nmolberg/hardware_dev/Pressure Broom 2/Pressure Broom 2.kicad_pcb

## KiCad design Pressure Broom 2/Pressure Broom 2.kicad_pcb (2025-07-15)

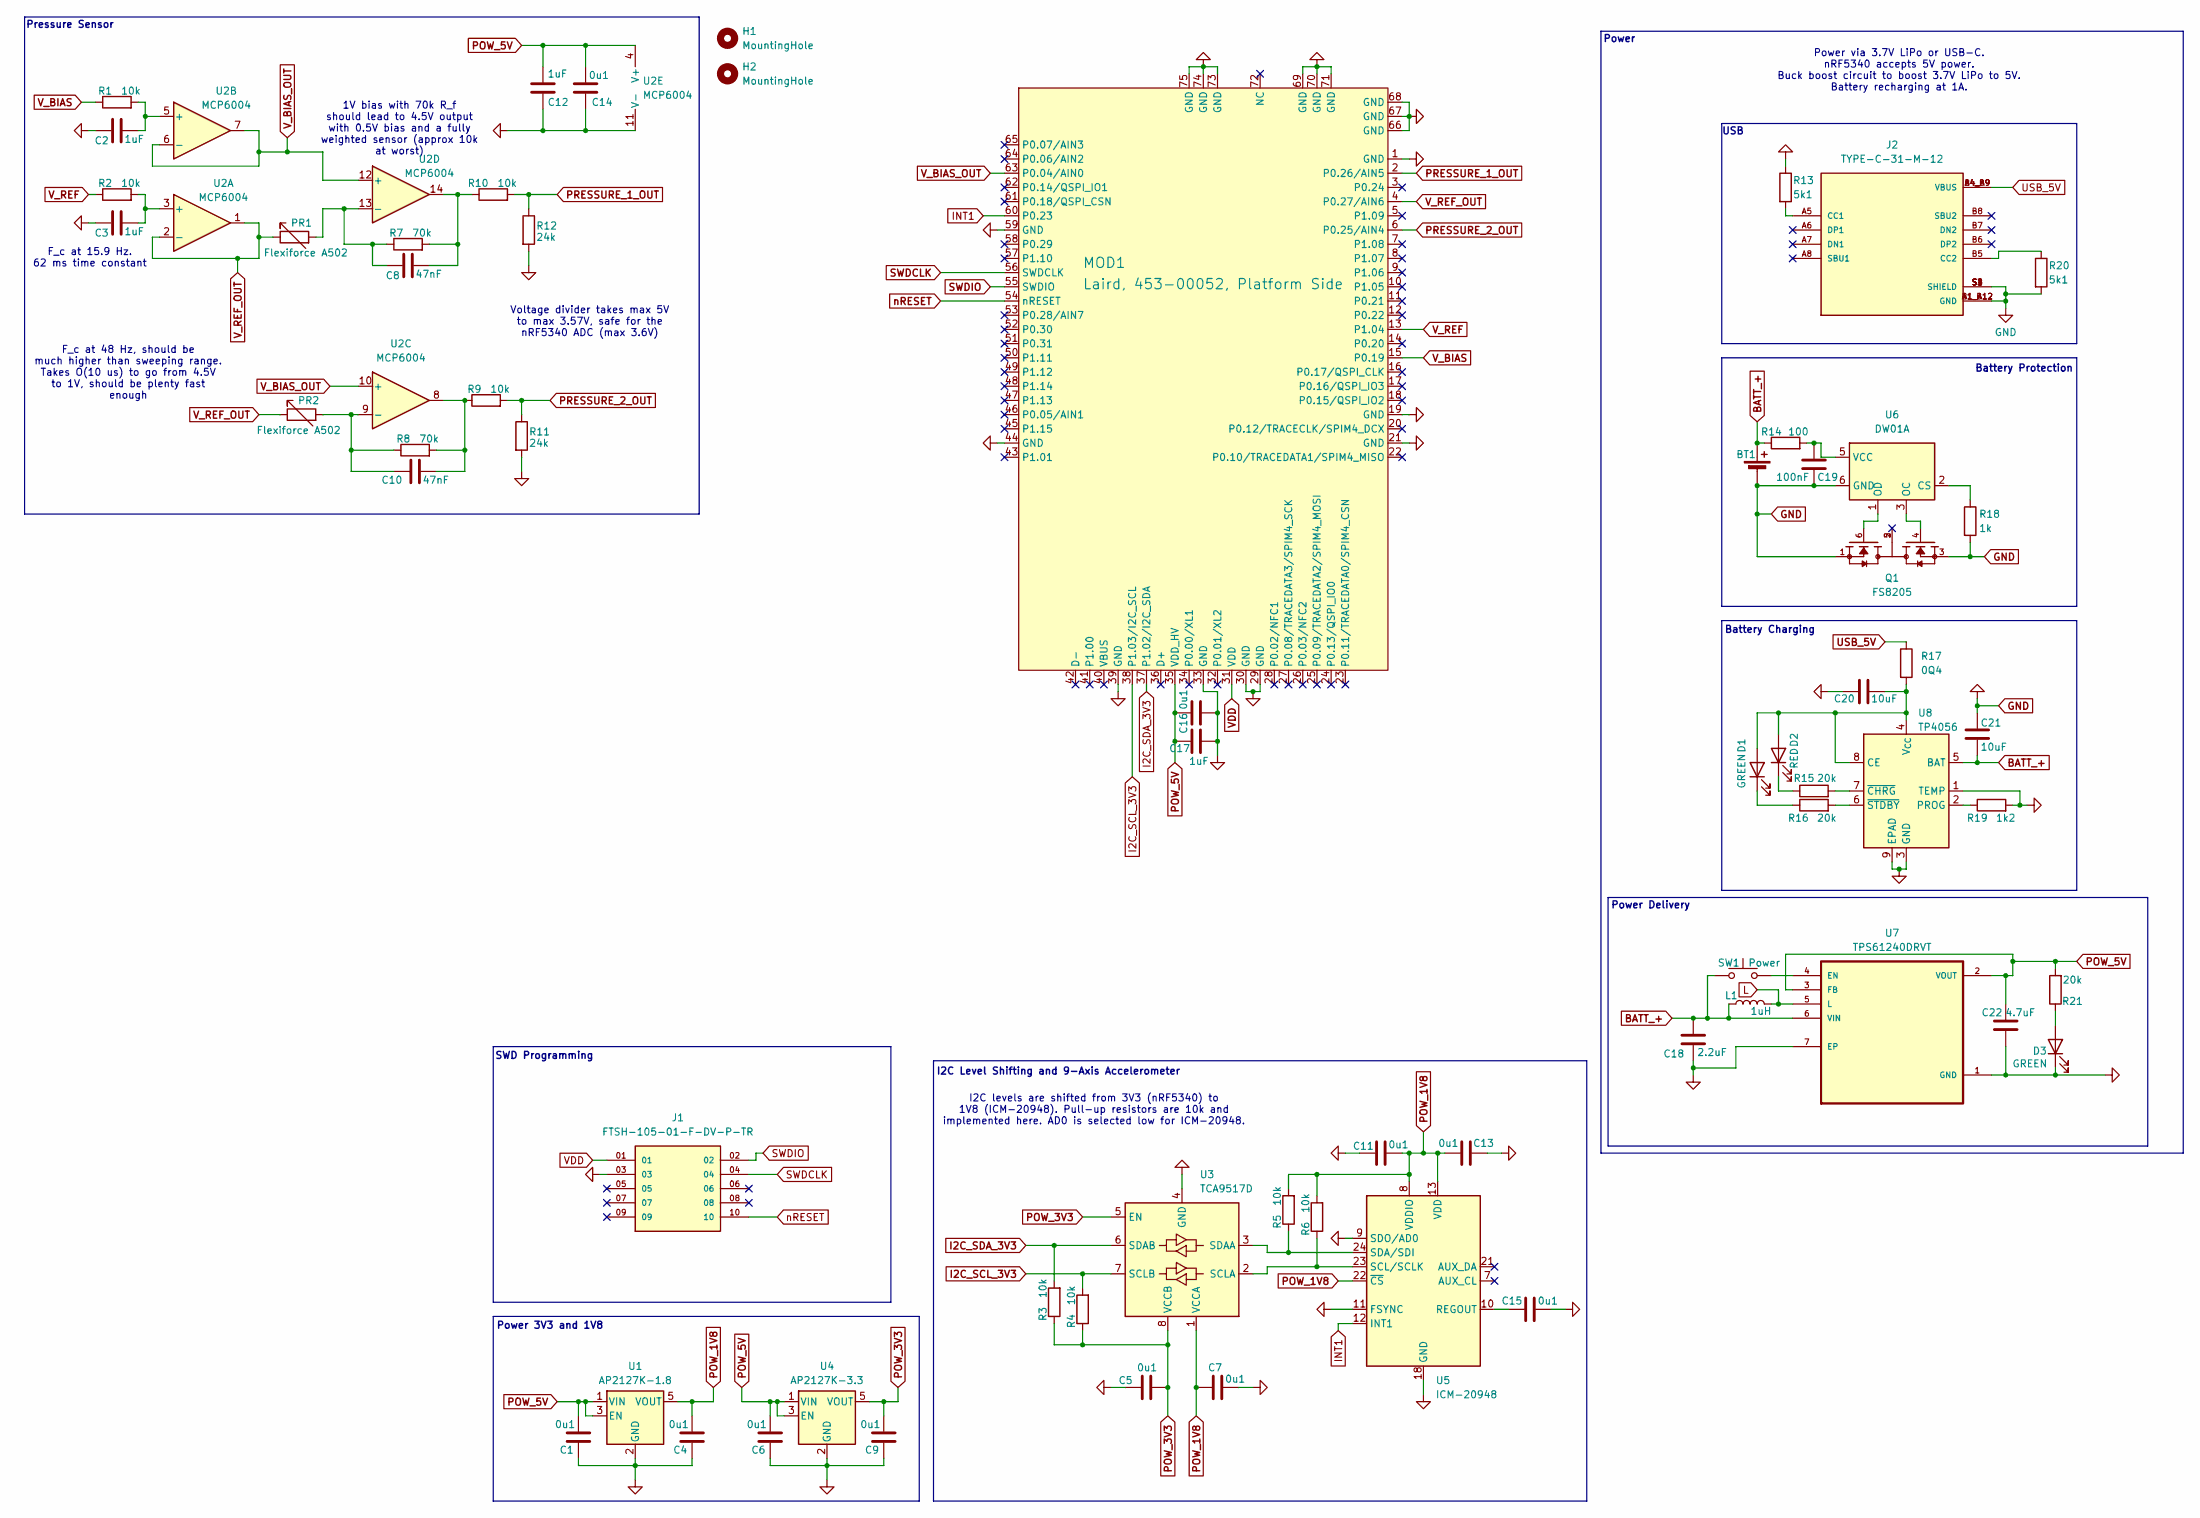
[picture p1: schematic Pressure Broom 2.kicad_sch]

Parts:
BT1: Battery_Cell; JST_PH_S2B-PH-K_1x02_P2.00mm_Horizontal
C1, C4, C5, C6, C7, C9, C11, C13, C14, C15: 0u1; C_0402_1005Metric
C2, C3, C12: 1uF; C_0402_1005Metric
C8, C10: 47nF; C_0402_1005Metric
C16: 0u1; C_0603_1608Metric
C17: 1uF; C_0603_1608Metric
C18: 2.2uF; C_0603_1608Metric
C19: 100nF; C_0603_1608Metric
C20, C21: 10uF; C_0603_1608Metric
C22: 4.7uF; C_0603_1608Metric
D1, D3: GREEN; LED_0402_1005Metric
D2: RED; LED_0402_1005Metric
H1, H2: MountingHole; MountingHole_2.2mm_M2
J1: FTSH-105-01-F-DV-P-TR; SAMTEC_FTSH-105-01-F-DV-P-TR; PARTREV R
J2: TYPE-C-31-M-12; HRO_TYPE-C-31-M-12; PARTREV 2020.12.08
L1: 1uH; L_0603_1608Metric; Part LQM21PN1R0MC0
MOD1: Laird, 453-00052, Platform Side; Ezurio Module; Manufacturer Part Number 453-00052
PR1, PR2: Flexiforce A502; Tekscan Pressure Sensor
Q1: FS8205; SOT95P280X145-6N; PARTREV 1.9
R1, R2, R3, R5, R9, R10: 10k; R_0402_1005Metric_Pad0.72x0.64mm_HandSolder
R4, R6: 10k; R_0603_1608Metric
R7, R8: 70k; R_0402_1005Metric_Pad0.72x0.64mm_HandSolder
R11, R12: 24k; R_0402_1005Metric_Pad0.72x0.64mm_HandSolder
R13, R20: 5k1; R_0402_1005Metric_Pad0.72x0.64mm_HandSolder
R14: 100; R_0402_1005Metric_Pad0.72x0.64mm_HandSolder
R15, R16, R21: 20k; R_0402_1005Metric_Pad0.72x0.64mm_HandSolder
R17: 0Q4; R_0402_1005Metric_Pad0.72x0.64mm_HandSolder
R18: 1k; R_0402_1005Metric_Pad0.72x0.64mm_HandSolder
R19: 1k2; R_0402_1005Metric_Pad0.72x0.64mm_HandSolder
SW1: Power; YTSPS-22E58LM
U1: AP2127K-1.8; SOT-23-5
U2: MCP6004; SOP65P640X120-14N
U3: TCA9517D; VSSOP-8_3x3mm_P0.65mm
U4: AP2127K-3.3; SOT-23-5
U5: ICM-20948; InvenSense_QFN-24_3x3mm_P0.4mm
U6: DW01A; SOT-23-6
U7: TPS61240DRVT
U8: TP4056; SOIC-8-1EP_3.9x4.9mm_P1.27mm_EP2.41x3.3mm_ThermalVias

Connections:
BATT_+: BT1.1 (+), C18.2, C21.2, L1.1, R14.1, SW1.1, U7.6 (VIN), U8.5 (BAT)
GND: BT1.2 (-), C1.1, C2.2, C3.2, C4.1, C5.2, C6.1, C7.1, C9.1, C11.2, C12.2, C13.2, C14.2, C15.2, C16.2, C17.2, C18.1, C19.2, C20.1, C21.1, C22.1, D3.1 (K), J1.03, J2.A1_B12 (GND), J2.B1_A12 (GND), J2.S1 (SHIELD), J2.S2 (SHIELD), J2.S3 (SHIELD), J2.S4 (SHIELD), MOD1.1 (GND), MOD1.19 (GND), MOD1.21 (GND), MOD1.29 (GND), MOD1.30 (GND), MOD1.33 (GND), MOD1.39 (GND), MOD1.44 (GND), MOD1.59 (GND), MOD1.66 (GND), MOD1.67 (GND), MOD1.68 (GND), MOD1.69 (GND), MOD1.70 (GND), MOD1.71 (GND), MOD1.73 (GND), MOD1.74 (GND), MOD1.75 (GND), Q1.1, Q1.3, R11.2, R12.2, R13.1, R18.2, R19.2, R20.2, U1.2 (GND), U2.11 (V-), U3.4 (GND), U4.2 (GND), U5.9 (SDO/AD0), U5.11 (FSYNC), U5.18 (GND), U5.20 (GND), U6.6 (GND), U7.1 (GND), U7.7 (EP), U8.1 (TEMP), U8.3 (GND), U8.9 (EPAD)
I2C_SCL_3V3: MOD1.38 (P1.03/I2C_SCL), R4.2, U3.7 (SCLB)
I2C_SDA_3V3: MOD1.37 (P1.02/I2C_SDA), R3.2, U3.6 (SDAB)
INT1: MOD1.60 (P0.23), U5.12 (INT1)
L: L1.2, U7.5 (L)
unnamed: C8.1, R7.2, R10.1, U2.14
unnamed: C10.1, R8.2, R9.1, U2.8
unnamed: C20.2, D1.2 (A), D2.2 (A), R17.2, U8.4 (V_{CC}), U8.8 (CE)
unnamed: D1.1 (K), R16.1
unnamed: D2.1 (K), R15.1
unnamed: D3.2 (A), R21.1
unnamed: J2.A5 (CC1), R13.2
unnamed: J2.B5 (CC2), R20.1
unnamed: C3.1, R2.2, U2.3 (+)
unnamed: C2.1, R1.2, U2.5 (+)
unnamed: C10.2, PR2.2, R8.1, U2.9 (-)
unnamed: C8.2, PR1.2, R7.1, U2.13 (-)
unnamed: R6.1, U3.2 (SCLA), U5.23 (SCL/SCLK)
unnamed: R5.1, U3.3 (SDAA), U5.24 (SDA/SDI)
unnamed: C15.1, U5.10 (REGOUT)
unnamed: R18.1, U6.2 (CS)
unnamed: Q1.4, U6.3 (OC)
unnamed: Q1.6, U6.1 (OD)
unnamed: C19.1, R14.2, U6.5 (VCC)
unnamed: SW1.2, U7.4 (EN)
unnamed: R19.1, U8.2 (PROG)
unnamed: R15.2, U8.7 (~CHRG)
unnamed: R16.2, U8.6 (~STDBY)
POW_1V8: C4.2, C7.2, C11.1, C13.1, R5.2, R6.2, U1.5 (VOUT), U3.1 (VCCA), U5.8 (VDDIO), U5.13 (VDD), U5.22 (~CS)
POW_3V3: C5.1, C9.2, R3.1, R4.1, U3.5 (EN), U3.8 (VCCB), U4.5 (VOUT)
POW_5V: C1.2, C6.2, C12.1, C14.1, C16.1, C17.1, C22.2, MOD1.35 (VDD_HV), R21.2, U1.1 (VIN), U1.3 (EN), U2.4 (V+), U4.1 (VIN), U4.3 (EN), U7.2 (VOUT), U7.3 (FB)
PRESSURE_1_OUT: MOD1.2 (P0.26/AIN5), R10.2, R12.1
PRESSURE_2_OUT: MOD1.6 (P0.25/AIN4), R9.2, R11.1
SWDCLK: J1.04, MOD1.56 (SWDCLK)
SWDIO: J1.02, MOD1.55 (SWDIO)
USB_5V: J2.A4_B9 (VBUS), J2.B4_A9 (VBUS), R17.1
VDD: J1.01, MOD1.31 (VDD)
V_BIAS: MOD1.15 (P0.19), R1.1
V_BIAS_OUT: MOD1.63 (P0.04/AIN0), U2.6 (-), U2.7, U2.10 (+), U2.12 (+)
V_REF: MOD1.13 (P1.04), R2.1
V_REF_OUT: MOD1.4 (P0.27/AIN6), PR1.1, PR2.1, U2.1, U2.2 (-)
nRESET: J1.10, MOD1.54 (nRESET)

Notes on the sheet:
Power
USB
Battery Charging
I2C Level Shifting and 9-Axis Accelerometer
Voltage divider takes max 5V to max 3.57V, safe for the nRF5340 ADC (max 3.6V)
1V bias with 70k R_f should lead to 4.5V output with 0.5V bias and a fully weighted sensor (approx 10k at worst)
Power Delivery
Power via 3.7V LiPo or USB-C. nRF5340 accepts 5V power. Buck boost circuit to boost 3.7V LiPo to 5V. Battery recharging at 1A.
Pressure Sensor
Power 3V3 and 1V8
F_c at 48 Hz, should be much higher than sweeping range. Takes O(10 us) to go from 4.5V to 1V, should be plenty fast enough
F_c at 15.9 Hz. 62 ms time constant
I2C levels are shifted from 3V3 (nRF5340) to 1V8 (ICM-20948). Pull-up resistors are 10k and implemented here. AD0 is selected low for ICM-20948.
Battery Protection
SWD Programming

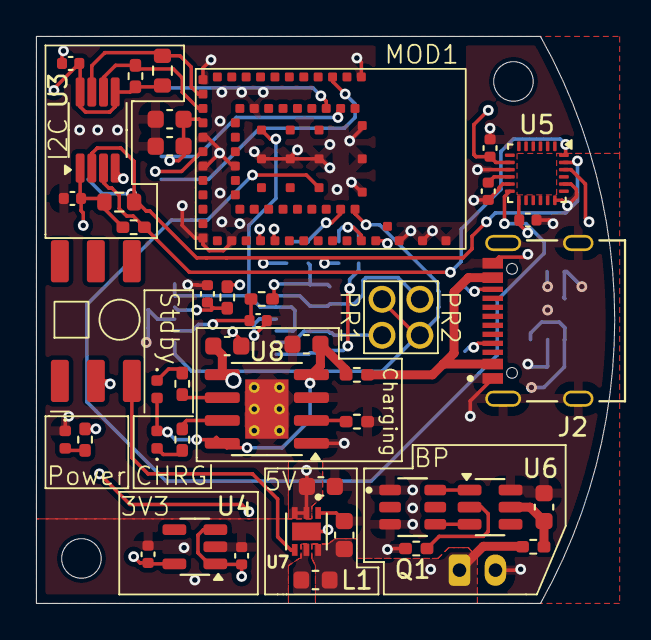
[picture p2: board Pressure Broom 2.kicad_pcb from above]

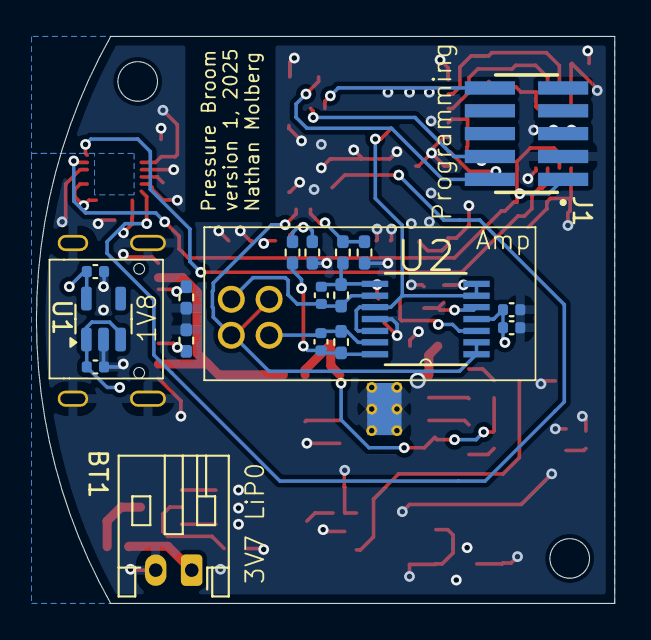
[picture p3: board Pressure Broom 2.kicad_pcb from below]

Board: 4 copper layers, 32.1 x 31.5 mm, 65 parts (18 on the bottom side), 43 nets.
