nmolberg/hardware_dev/(commit log)

2025-07-15 Add datasheets and correct project
    [Pressure Broom 2.kicad_pcb, Pressure Broom 2.kicad_sch, Pressure Broom.kicad_pcb, Pressure Broom.kicad_sch, power_management.kicad_sch]
2025-07-15 Add project files?
    [Pressure Broom 2.kicad_pcb, Pressure Broom 2.kicad_sch]
2025-07-15 Documentation and Flexiforce datasheets
    [Pressure Broom 2.kicad_sch]
